widerllama2014/ecgsimulator/electronica/kicad/Lista de materiales .xlsx

Reference | Qty | Value | DNP | Exclude from BOM | Exclude from Board | Exclude from Simulation | Exclude from Position Files | Footprint | Datasheet
BT1 |  | 1 | LiPo_1S_3V7 |  |  |  | ${EXCLUDE_FROM_POS_FILES} | Connector_JST:JST_PH_B2B-PH-K_1x02_P2.00mm_Vertical
C1 | C4 | 2 | 100n |  |  |  |  | ${EXCLUDE_FROM_POS_FILES} | Capacitor_THT:C_Disc_D5.0mm_W2.5mm_P2.50mm
C2 |  | 1 | 10n |  |  |  | ${EXCLUDE_FROM_POS_FILES} | Capacitor_THT:C_Disc_D5.0mm_W2.5mm_P2.50mm
C3 |  | 1 | 100u |  |  |  | ${EXCLUDE_FROM_POS_FILES} | Capacitor_THT:CP_Radial_D6.3mm_P2.50mm
D1 |  | 1 | VERDE_ON |  |  |  | ${EXCLUDE_FROM_POS_FILES} | LED_THT:LED_D5.0mm
D2 |  | 1 | 1N5819 |  |  |  | ${EXCLUDE_FROM_POS_FILES} | Diode_THT:D_DO-41_SOD81_P10.16mm_Horizontal
D3 |  | 1 | AZUL_BT |  |  |  | ${EXCLUDE_FROM_POS_FILES} | LED_THT:LED_D5.0mm
J_BNC1 |  | 1 | BNC |  |  |  | ${EXCLUDE_FROM_POS_FILES}
J_LA1 |  | 1 | LA |  |  |  | ${EXCLUDE_FROM_POS_FILES} | TestPoint:TestPoint_THTPad_D2.0mm_Drill1.0mm
J_LL1 |  | 1 | LL |  |  |  | ${EXCLUDE_FROM_POS_FILES} | TestPoint:TestPoint_THTPad_D2.0mm_Drill1.0mm
J_RA1 |  | 1 | RA |  |  |  | ${EXCLUDE_FROM_POS_FILES} | TestPoint:TestPoint_THTPad_D2.0mm_Drill1.0mm
J_RL1 |  | 1 | RL |  |  |  | ${EXCLUDE_FROM_POS_FILES} | TestPoint:TestPoint_THTPad_D2.0mm_Drill1.0mm
M1 |  | 1 | TP4056_modulo |  |  |  | ${EXCLUDE_FROM_POS_FILES} | TP4056_modulo:TP4056_modulo
M2 |  | 1 | MT3608 |  |  |  | ${EXCLUDE_FROM_POS_FILES} | MT3608_DC:MT3608_DC
R1 | R7 | 2 | 330 |  |  |  |  | ${EXCLUDE_FROM_POS_FILES} | Resistor_THT:R_Axial_DIN0207_L6.3mm_D2.5mm_P10.16mm_Horizontal
R2 |  | 1 | 1k |  |  |  | ${EXCLUDE_FROM_POS_FILES} | Resistor_THT:R_Axial_DIN0207_L6.3mm_D2.5mm_P10.16mm_Horizontal
R3 |  | 1 | 10k |  |  |  | ${EXCLUDE_FROM_POS_FILES} | Resistor_THT:R_Axial_DIN0207_L6.3mm_D2.5mm_P10.16mm_Horizontal
R4 |  | 1 | 330k |  |  |  | ${EXCLUDE_FROM_POS_FILES} | Resistor_THT:R_Axial_DIN0207_L6.3mm_D2.5mm_P10.16mm_Horizontal
R5 | R6 | 2 | 100 |  |  |  |  | ${EXCLUDE_FROM_POS_FILES} | Resistor_THT:R_Axial_DIN0207_L6.3mm_D2.5mm_P10.16mm_Horizontal
SW1 |  | 1 | SPST |  |  |  | ${EXCLUDE_FROM_POS_FILES} | SW_Push_2P:SW_Push_2P
U1 |  | 1 | ESP32-S3-DEVKITC-1-N16R8V |  |  |  | ${EXCLUDE_FROM_POS_FILES} | ESP32-S3-DEVKITC-1-N16R8V:XCVR_ESP32-S3-DEVKITC-1-N16R8V
