widerllama2014/ecgsimulator/docs/bitacora.md

# Bitácora del proyecto

Registro cronológico de avances, decisiones y problemas.

## 2026-10-29 — PCB: colocación por bloques, contorno y agujeros

- Se colocaron los 23 footprints en el PCB en **dos mitades** (arriba señal + bornes
  centrados + switch + LEDs + título "Simulador de ECG"; abajo ESP32 con USB al borde
  y alimentación batería→TP→MT con USB-C al borde).
- **Contorno de placa 80×130 mm** y **4 agujeros de montaje Ø3,2 mm** (fresados como
  círculos en Edge.Cuts), más una línea guía en la mitad.
- DRC: sin solapes ni cortos por colocación. **Quedan clearances intrínsecos** de
  piezas estándar vs la regla de 0,8 mm (LEDs 0,74 mm, TP 0,6–0,7 mm, **JST 0,25 mm**)
  → decisión pendiente (la batería JST no es fresable a 0,8 mm). Silk solapado
  (cosmético, se arregla con autoplace de campos). Falta re-importar para sincronizar
  footprints de M1/BT1 y el **ruteo** (1 cara).

## 2026-10-28 — Inicio del PCB: footprint del interruptor y reglas CNC

- **SW1:** se creó un footprint propio `SW_Push_2P` (pulsador enclavado de 2 pines;
  cuerpo 13,12×8,18 mm, pines a 4,88 mm, agujero 1,0 mm) en `electronica/libraries/` y
  se asignó a SW1. Validado con ERC (0 violaciones).
- **Reglas de diseño (CNC) configuradas** en el proyecto: ancho de pista mínimo
  **0,8 mm**, separación cobre-cobre **0,8 mm** (clase Default y reglas globales).
- **Pendiente de footprint:** solo el **BNC** (en stand-by por decisión del equipo).
- **Siguiente:** importar footprints al PCB (Update PCB from Schematic), colocar por
  bloques, contorno de placa + 4 agujeros Ø3,2 mm, ruteo a 1 cara (B.Cu).

## 2026-10-28 — Asignación de footprints (THT)

- Footprints asignados y validados (ERC 0): resistencias →
  `R_Axial_DIN0207_L6.3mm_D2.5mm_P10.16mm_Horizontal`; cerámicos (C1/C2/C4) →
  `C_Disc_D5.0mm_W2.5mm_P2.50mm`; electrolítico C3 → `CP_Radial_D6.3mm_P2.50mm`;
  LEDs → `LED_D5.0mm`; diodo 1N5819 → `D_DO-41_SOD81_P10.16mm_Horizontal`;
  batería → `JST_PH_B2B-PH-K_1x02_P2.00mm_Vertical`; bornes RA/LA/LL/RL →
  `TestPoint_THTPad_D2.0mm_Drill1.0mm` (jacks banana van en panel, por cable).
- **Pendientes de footprint:** SW1 (tipo de interruptor por confirmar) y J_BNC
  (el CN381 es conector de cable, no de PCB → se definirá cómo conecta el coaxial).
- **Dudas de valores a resolver con el equipo:** atenuador en esquema = 330k pero el
  equipo consiguió 100k; verificar que haya dos 330 Ω (LED encendido + LED BT) y los
  condensadores C3 (100 µF) y C4 (100 n) de desacople.
- Respaldo previo: `Proyecto de prueba.kicad_sch.bak2`.

## 2026-10-27 — Esquemático reorganizado en 3 bloques con cableado real

- Se reorganizó el esquemático en **tres bloques** con marco y título, cableado con
  **cables reales** (no solo net labels): **ALIMENTACIÓN**, **CONEXIONES ESP32-S3** y
  **CIRCUITO DE SEÑAL (ECG)**, al estilo del primer prototipo.
- GND y +5V con símbolos de power; `PWM` como etiqueta que cruza del bloque ESP32 al de
  señal. Negativo de la batería referenciado a GND.
- Revalidado con `kicad-cli`: **ERC 0 violaciones** y **netlist verificada** (sin
  cortocircuitos; todas las redes coinciden con el diseño). Generado con
  `scratchpad/gen2.py` (incluye la transformación de rotación calibrada).

## 2026-10-27 — Esquemático KiCad completo y validado (ERC 0 violaciones)

- Se cerró el **esquemático completo** en `electronica/kicad/Proyecto de prueba.kicad_sch`
  con todos los bloques: ESP32-S3, alimentación (BT1, M1 TP4056, SW1, M2 MT3608, D1,
  C3/C4), señal (R1/C1/R2/C2, TP1, BNC, R3, R4/R5, bornes LL/LA/RA/RL) y LEDs de
  estado (D2+R6 encendido, D3+R7 Bluetooth).
- **Conectividad por net labels**; validado con `kicad-cli sch erc` → **0 violaciones**.
  Netlist verificada: +5V, V5RAW, VSW, VBAT, GND, PWM, NODEA, SIG, LLN, LAN, PLED, BLED
  coinciden con el diseño. Pines no usados del ESP32 marcados como no-conectados.
- Símbolos de los módulos TP4056/MT3608 ajustados a pines `passive`; `PWR_FLAG` en +5V y
  GND. Librerías registradas (sym: MT3608_DC; fp: ESP32, MT3608_DC, TP4056_modulo).
- Respaldo del esquemático anterior: `Proyecto de prueba.kicad_sch.bak`.
- **Pendiente:** asignar footprints THT a pasivos/conectores; verificar medidas del
  footprint TP4056; layout de PCB (reglas CNC); el medidor SPBKBS-10 sigue excluido.

## 2026-10-27 — Diseño completo del circuito (netlist para KiCad)

- Se cerró el **diseño completo del esquemático** → `docs/diseno-esquematico.md`
  (BOM, netlist nodo por nodo, asignación de GPIOs y notas).
- **Decisiones finales:** se incluye **diodo Schottky D1 (1N5819)**; bornes de electrodo
  = **banana 4 mm hembra** (conexión directa del cable); GPIOs asignados
  (PWM=GPIO4, LED Bluetooth=GPIO5; LED encendido cableado al +5V).
- **Atenuador:** R3 = 330 kΩ con red R4/R5 (100 Ω) → DII≈2 mV, DI≈DIII≈1 mV a fondo de
  escala. Atenuación pasiva fija = **garantía de salida en mV aunque falle el firmware**.
- El medidor de carga (SPBKBS-10) queda **excluido por ahora** del esquemático.

## 2026-10-27 — Selección de componentes y opciones de compra

- **Librería del MCU:** se adopta la de SnapEDA para **ESP32-S3-DevKitC-1-N16R8V**
  (símbolo + footprint + STEP) → `electronica/libraries/`.
- **Alimentación cerrada:** se confirman **TP4056 (USB-C 1A)** + **boost MT3608 a 5 V**.
  El boost sube los 3,7 V de la LiPo 1S a 5 V (no se necesita batería de más voltaje).
- **Conector a osciloscopio:** BNC macho RG58 (CN381).
- **Medidor de nivel de carga 1S–8S** reemplaza al LED indicador de batería (D4/R8
  eliminados). *Pendiente: generar símbolo + footprint propios; hay STEP disponible.*
- **Se mantiene un LED de encendido (on/off)** y el LED de Bluetooth (GPIO).
- **Condensadores** C3 (100 µF) + C4 (100 nF) a la salida de 5 V del MT3608, cerca del
  pin 5 V del DevKit, para absorber los picos de corriente del Bluetooth.
- Opciones de compra y alternativas documentadas en `docs/compras.md`.

## 2026-10-27 — Reorganización del repositorio y definición de alcance (Parte II)

- Se reestructuró el repositorio según la estructura exigida por la rúbrica de la
  Parte II (`docs/`, `electronica/{kicad,libraries,outputs}/`, `firmware/`, `software/`).
- Se movió el proyecto de KiCad a `electronica/kicad/` y la biblioteca propia a
  `electronica/libraries/`. El informe de la Parte I quedó en `docs/informes/`.
- **Decisiones de diseño confirmadas:**
  - Microcontrolador: **ESP32-S3-DevKitC-1** (montado por headers).
  - **4 electrodos (RA/LA/LL/RL-N) → 3 derivaciones** bipolares (DI, DII, DIII).
  - El proyecto se divide en 3: **PCB física**, **software** (PC/teléfono) y
    **comunicación por Bluetooth (BLE)**.
  - La **interfaz** (selección de modo, amplitud, señal e interferencias) se realiza
    en **software**; en la placa quedan **LEDs de estado THT** (encendido, Bluetooth,
    batería).
  - Conectores en placa (no son salidas de ECG): **USB**, **cargador de batería**,
    **salida a osciloscopio (BNC)**.
  - Alimentación propuesta: **LiPo + TP4056** (carga) **+ boost a 5 V** → pin 5 V del
    DevKit. *(A confirmar.)*
  - Todos los componentes **THT**.
- **Pendiente:** cerrar detalle de batería/carga; integrar ESP32-S3, alimentación,
  LEDs y conectores en el esquemático; verificar bibliotecas; layout CNC.

<!-- Nuevas entradas arriba de esta línea, de más reciente a más antigua. -->
