widerllama2014/ecgsimulator/electronica/kicad/Proyecto de prueba.kicad_pcb

## KiCad design electronica/kicad/Proyecto de prueba.kicad_pcb (2026-10-31)

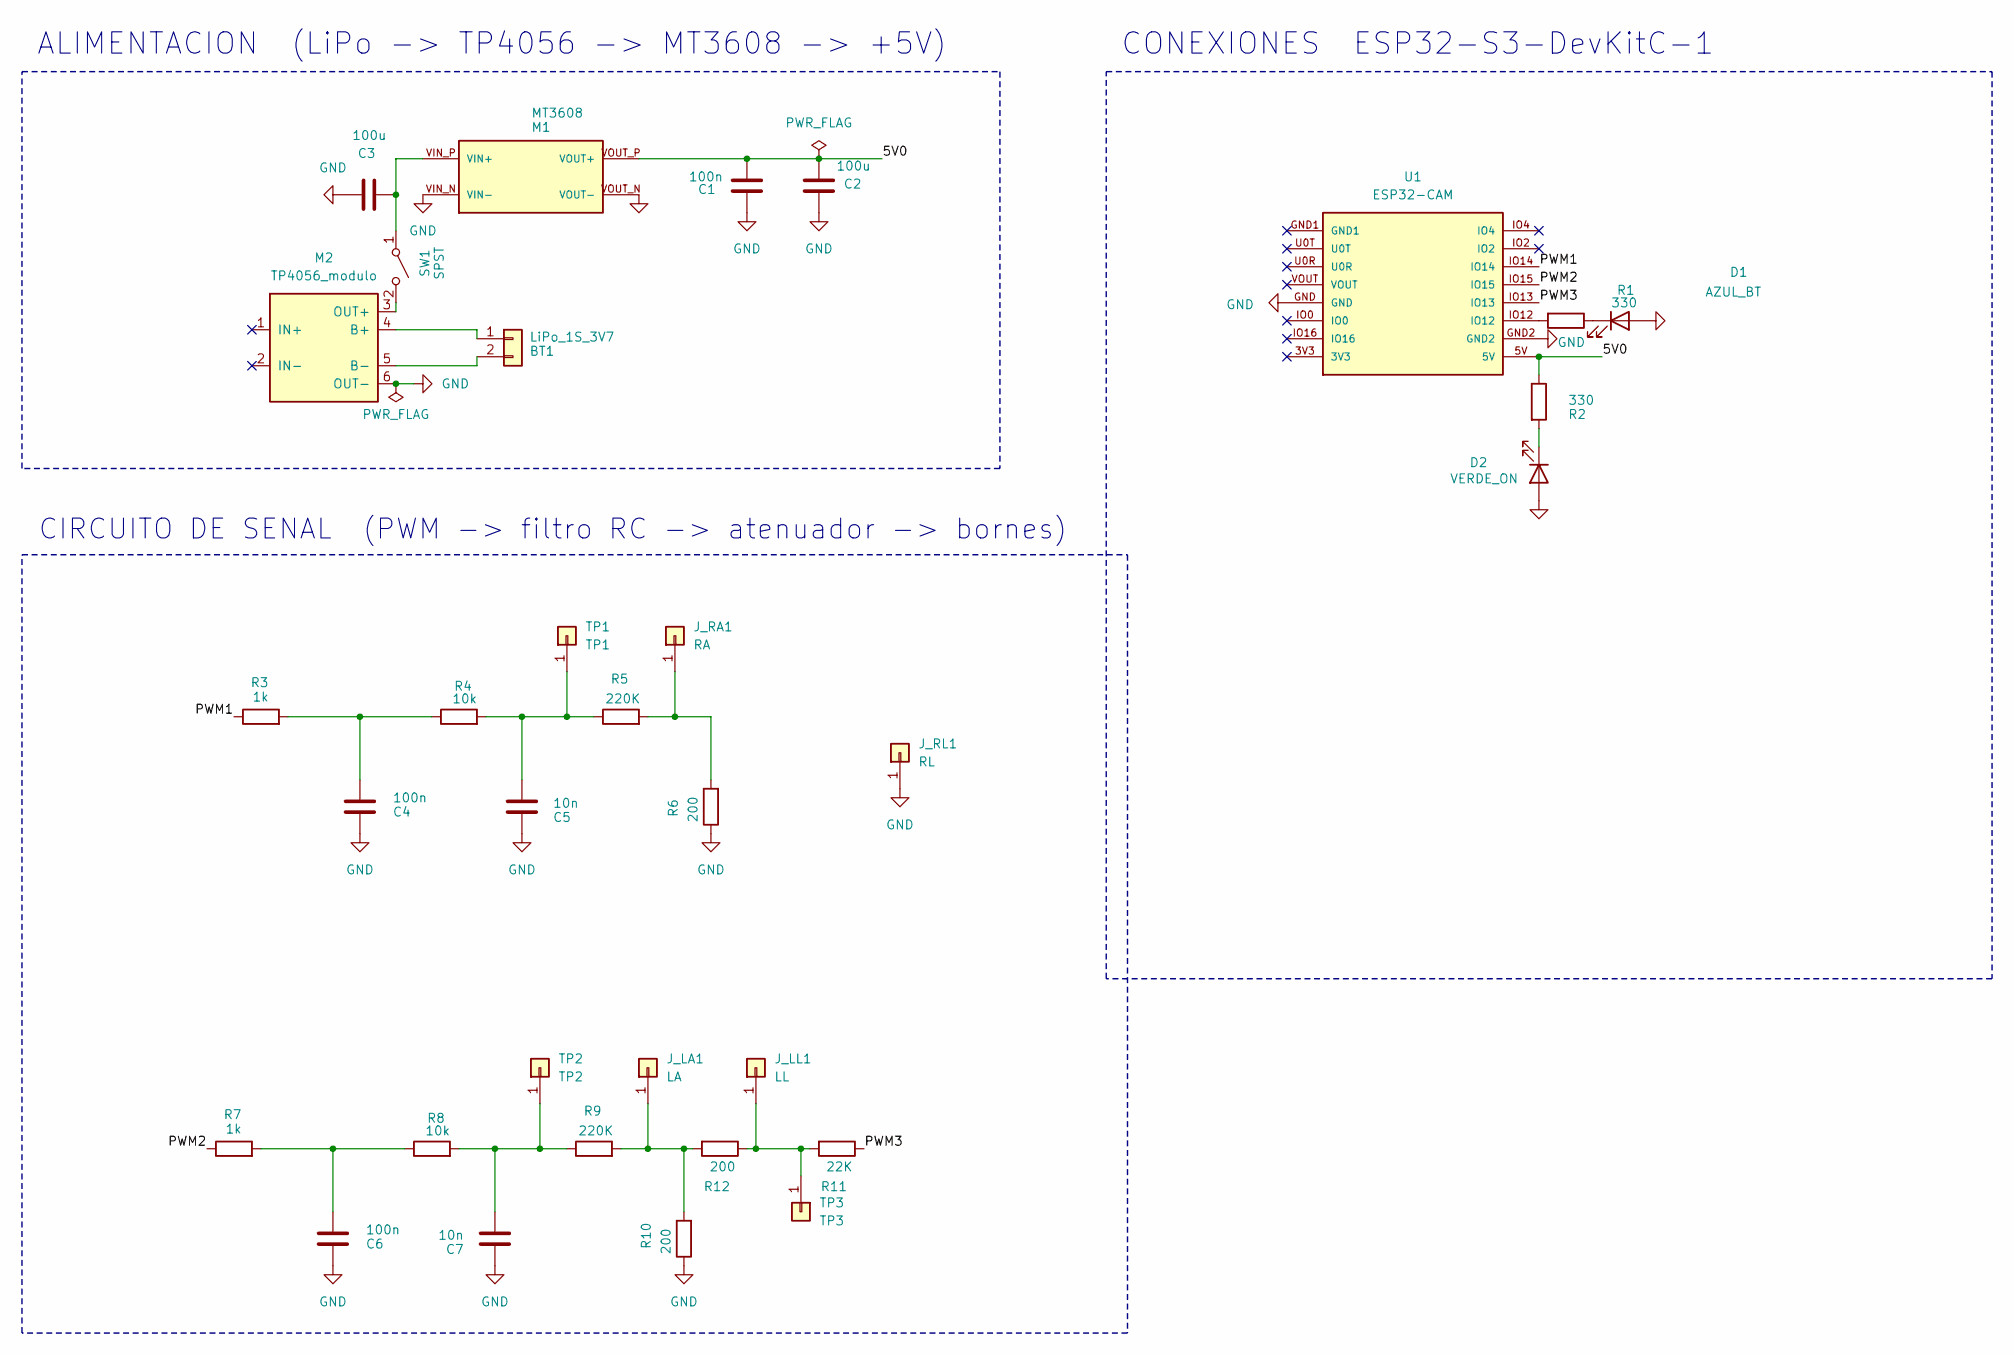
[picture p9: schematic Proyecto de prueba.kicad_sch]

Parts:
BT1: LiPo_1S_3V7; JST_PH_B2B-PH-K_1x02_P2.00mm_Vertical
C1, C4, C6: 100n; C_Disc_D5.0mm_W2.5mm_P2.50mm
C2, C3: 100u; CP_Radial_D6.3mm_P2.50mm
C5, C7: 10n; C_Disc_D5.0mm_W2.5mm_P2.50mm
D1: AZUL_BT; LED_D5.0mm
D2: VERDE_ON; LED_D5.0mm
J_LA1: LA; TestPoint_THTPad_D2.0mm_Drill1.0mm
J_LL1: LL; TestPoint_THTPad_D2.0mm_Drill1.0mm
J_RA1: RA; TestPoint_THTPad_D2.0mm_Drill1.0mm
J_RL1: RL; TestPoint_THTPad_D2.0mm_Drill1.0mm
M1: MT3608; MT3608_DC
M2: TP4056_modulo
R1, R2: 330; R_Axial_DIN0207_L6.3mm_D2.5mm_P10.16mm_Horizontal
R3, R7: 1k; R_Axial_DIN0207_L6.3mm_D2.5mm_P10.16mm_Horizontal
R4, R8: 10k; R_Axial_DIN0207_L6.3mm_D2.5mm_P10.16mm_Horizontal
R5, R9: 220K; R_Axial_DIN0207_L6.3mm_D2.5mm_P10.16mm_Horizontal
R6, R10, R12: 200; R_Axial_DIN0207_L6.3mm_D2.5mm_P10.16mm_Horizontal
R11: 22K; R_Axial_DIN0207_L6.3mm_D2.5mm_P10.16mm_Horizontal
SW1: SPST; SW_Push_2P
TP1: TP1; TestPoint_THTPad_D2.0mm_Drill1.0mm
TP2: TP2; TestPoint_THTPad_D2.0mm_Drill1.0mm
TP3: TP3; TestPoint_THTPad_D2.0mm_Drill1.0mm
U1: ESP32-CAM

Connections:
/5V0: C1.2, C2.1, M1.VOUT_P (VOUT+), R2.1, U1.5V
/PWM1: R3.1, U1.IO14
/PWM2: R7.1, U1.IO15
/PWM3: R11.1, U1.IO13
GND: C1.1, C2.2, C3.2, C4.2, C5.2, C6.2, C7.2, D1.2 (A), D2.2 (A), J_RL1.1 (Pin_1_1), M1.VIN_N (VIN-), M1.VOUT_N (VOUT-), M2.6 (OUT-), R6.1, R10.1, U1.GND, U1.GND2
unnamed: BT1.1, M2.4 (B+)
unnamed: BT1.2, M2.5 (B-)
unnamed: C4.1, R3.2, R4.1
unnamed: C6.1, R7.2, R8.1
unnamed: D1.1 (K), R1.1
unnamed: D2.1 (K), R2.2
unnamed: J_LA1.1 (Pin_1_1), R9.2, R10.2, R12.2
unnamed: J_LL1.1 (Pin_1_1), R11.2, R12.1, TP3.1 (Pin_1_1)
unnamed: J_RA1.1 (Pin_1_1), R5.2, R6.2
unnamed: C3.1, M1.VIN_P (VIN+), SW1.1 (A)
unnamed: M2.3 (OUT+), SW1.2 (B)
unnamed: R1.2, U1.IO12
unnamed: C5.1, R4.2, R5.1, TP1.1 (Pin_1_1)
unnamed: C7.1, R8.2, R9.1, TP2.1 (Pin_1_1)

Notes on the sheet:
CIRCUITO DE SENAL (PWM -> filtro RC -> atenuador -> bornes)
CONEXIONES ESP32-S3-DevKitC-1
ALIMENTACION (LiPo -> TP4056 -> MT3608 -> +5V)

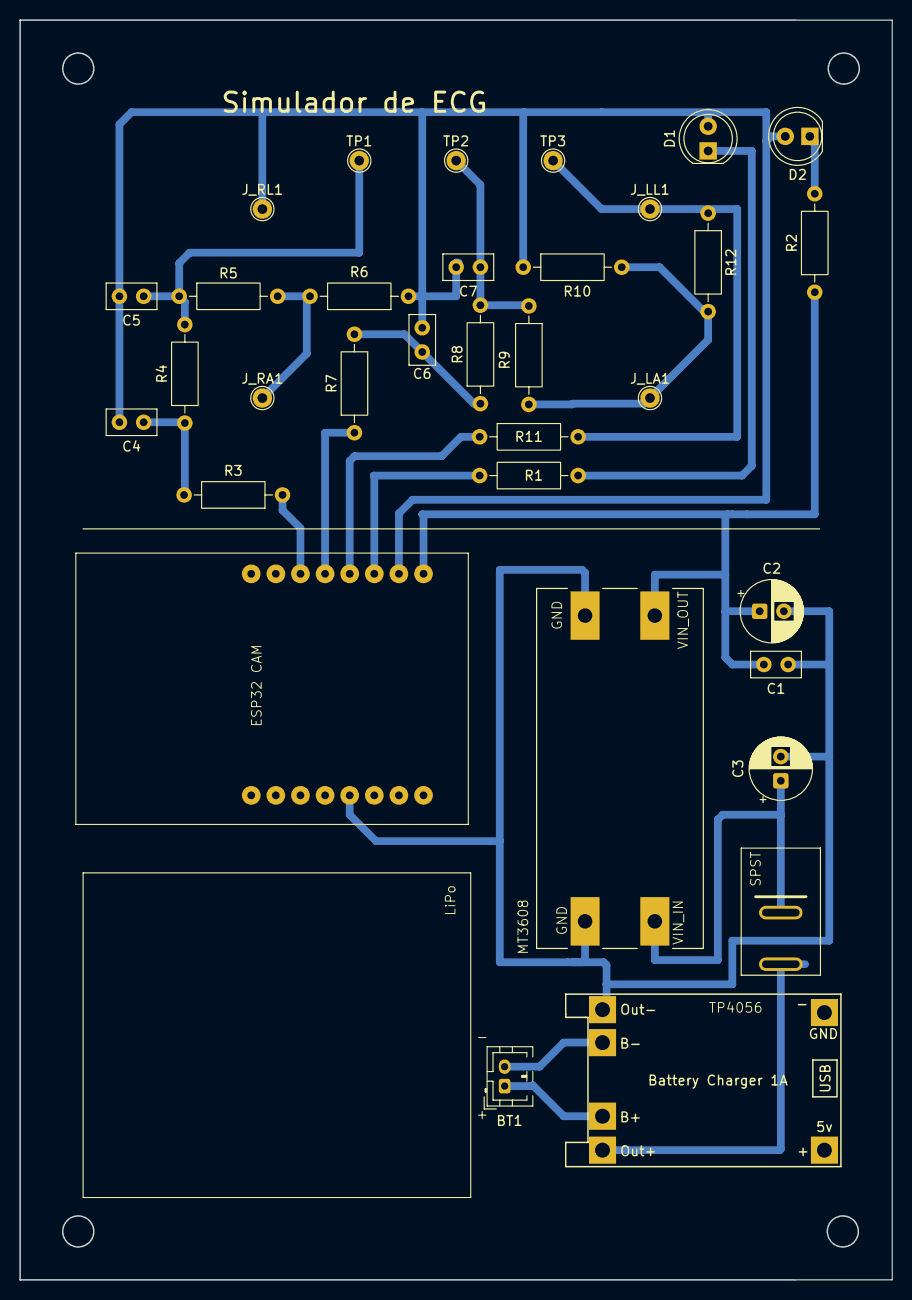
[picture p10: board Proyecto de prueba.kicad_pcb from above]

Board: 2 copper layers, 90.0 x 130.0 mm, 33 parts (0 on the bottom side), 19 nets.
