widerllama2014/ecgsimulator/(commit log)

2026-10-23 "footprints added"
    [Proyecto de prueba.kicad_sch]
2026-10-27 Reorganiza el repositorio segun la estructura de la rubrica (Parte II)
    - Crea docs/{datasheets,informes}, bitacora.md; electronica/{kicad,libraries,
    outputs}; firmware/ y software/ (con .gitkeep donde corresponde).
    - Mueve el proyecto KiCad a electronica/kicad/ y la libreria propia a
    electronica/libraries/ (git mv, conserva historial).
    - Mueve el informe de la Parte I a docs/informes/.
    - Agrega README.md (resumen del proyecto y estructura) y LICENSE (MIT).
    - Amplia .gitignore con cache/backups de KiCad y archivos de SO.
    [Proyecto de prueba.kicad_pcb, Proyecto de prueba.kicad_sch]
2026-10-27 Elimina libreria PRUEBA 2 (no se usa; aun no hay libreria propia formal)
    Mantiene electronica/libraries/ con .gitkeep para la futura libreria del equipo.
2026-10-27 Cambia la licencia a CERN-OHL-S v2 (hardware abierto, recíproca fuerte)
    - Reemplaza MIT por el texto oficial de la CERN Open Hardware Licence v2
    Strongly Reciprocal: toda variación debe seguir siendo open hardware;
    permite vender y publicitar; exige conservar Notices y dar acceso a la
    fuente (Source Location).
    - README: sección de licencia con permisos/obligaciones y el aviso de
    copyright con Source Location (redirección al proyecto original).
2026-10-28 Asigna footprints THT a los componentes del esquematico
    Resistencias, condensadores (ceramicos y electrolitico), LEDs, diodo 1N5819, bateria (JST-PH) y bornes de electrodo (pad THT). Validado con ERC: 0 violaciones. Pendientes: footprint de SW1 y del BNC.
    [Proyecto de prueba.kicad_sch]
2026-10-28 Footprint del interruptor (SW_Push_2P) y reglas de diseno CNC (0.8mm)
    Crea footprint a medida del pulsador enclavado de 2 pines y lo asigna a SW1. Configura ancho de pista y separacion minima en 0.8mm para el CNC. BNC en stand-by.
    [Proyecto de prueba.kicad_sch]
2026-10-28 Corrige footprint del interruptor: ranuras para lenguetas planas
    Las patas son lenguetas de 0.44x3.7mm (no pines redondos) y el 4.88mm es el hueco, no centro-a-centro. Pitch real 5.32mm. Se cambian los agujeros redondos por ranuras 0.8x3.9mm, desplazadas a la derecha del cuerpo.
2026-10-29 Alinea numeracion de pines del TP4056 (simbolo y footprint)
    El simbolo refleja el modulo real (salida: afuera OUT a placa/switch, adentro B a bateria). Se renumeran los pads del footprint para que coincidan: 3=OUT+, 4=B+, 5=B-, 6=OUT-. Evita conexiones cruzadas en el PCB.
2026-10-29 PCB: colocacion por bloques, contorno 80x130mm y 4 agujeros 3.2mm
    Componentes ubicados en dos mitades (senal arriba; ESP32+alimentacion abajo con USB a los bordes). DRC sin solapes ni cortos de colocacion; quedan clearances intrinsecos de piezas (0.8mm vs pitch) y ruteo pendiente.
    [Proyecto de prueba.kicad_pcb]
2026-10-29 Se elimino el diodo. Se empezo el PCB
    [Lista de materiales .xlsx, Proyecto de prueba.csv, Proyecto de prueba.kicad_sch]
2026-10-30 PCB TERMINADO
    [Proyecto de prueba.kicad_pcb, Proyecto de prueba.kicad_sch]
2026-10-31 Firmware_1_Electrode y 3D listo
    [Proyecto de prueba.kicad_pcb, Proyecto de prueba.kicad_sch]
